colinoflynn/picoemp-tdc-paper/picoemp/hardware/gerbers/README.md

WARNING: Due to limtations in gerber editing these files are not fully anonymized.
