colinoflynn/picoemp-tdc-paper/paper-data-and-figures/caloutput.png

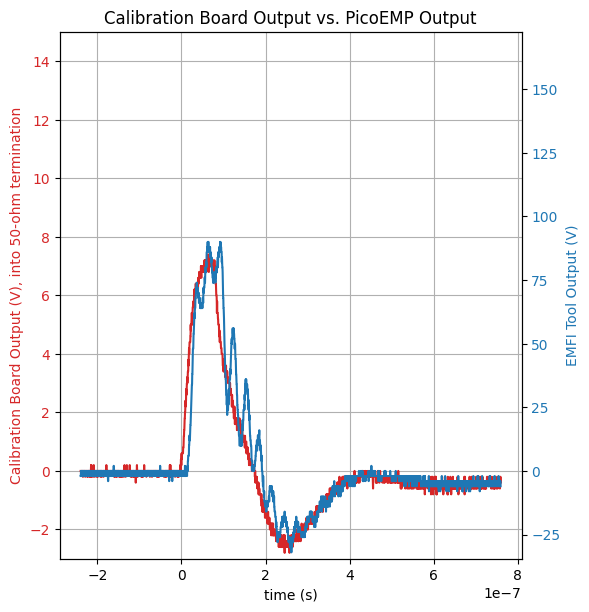
paper-data-and-figures/caloutput.png
