colinoflynn/picoemp-tdc-paper/paper-data-and-figures/caloutputcs.png

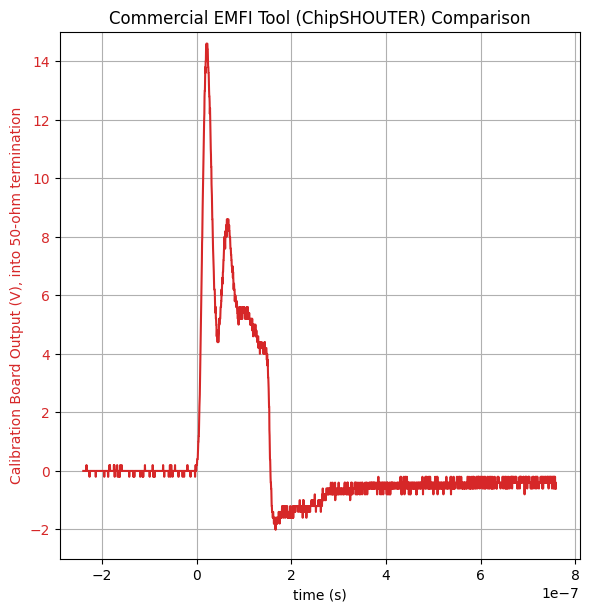
paper-data-and-figures/caloutputcs.png
