colinoflynn/picoemp-tdc-paper/paper-data-and-figures/FigureEMFIWidthEXT.png

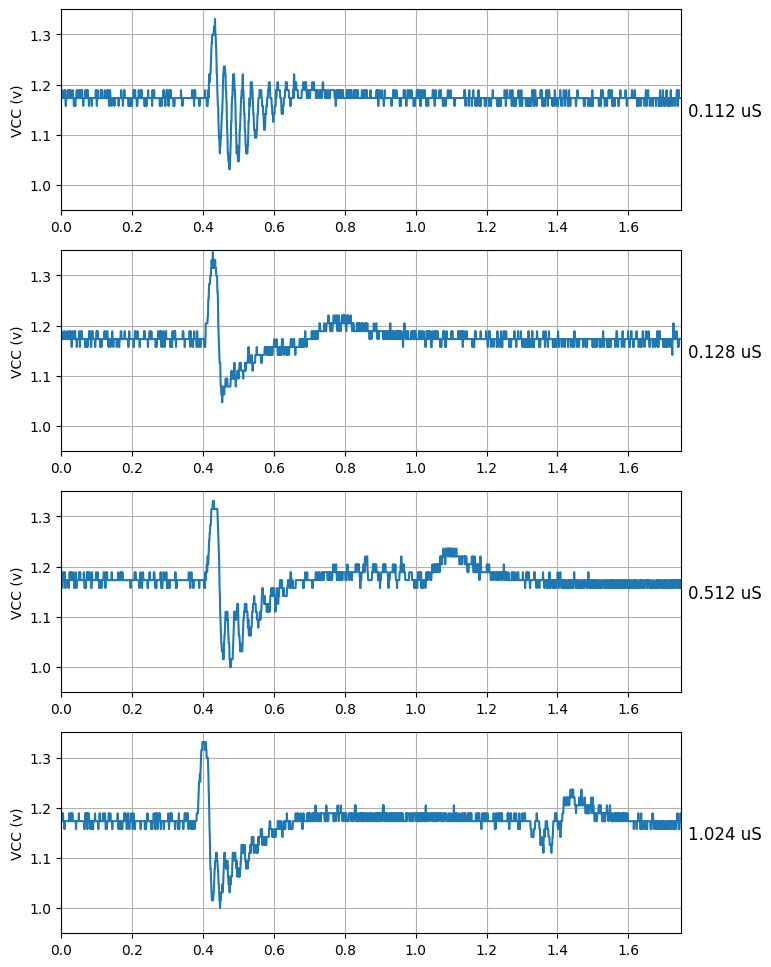
paper-data-and-figures/FigureEMFIWidthEXT.png
