colinoflynn/picoemp-tdc-paper/paper-data-and-figures/FigureEMFIWidthTDC.png

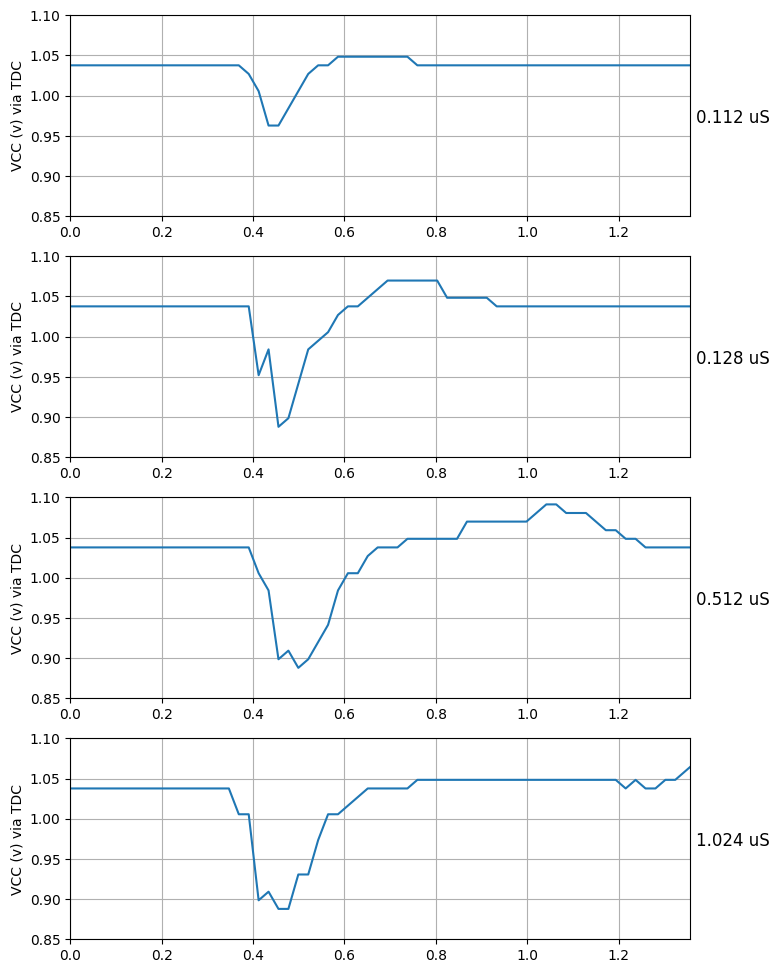
paper-data-and-figures/FigureEMFIWidthTDC.png
