colinoflynn/picoemp-tdc-paper/paper-data-and-figures/FigureHWAESVCCEXT.png

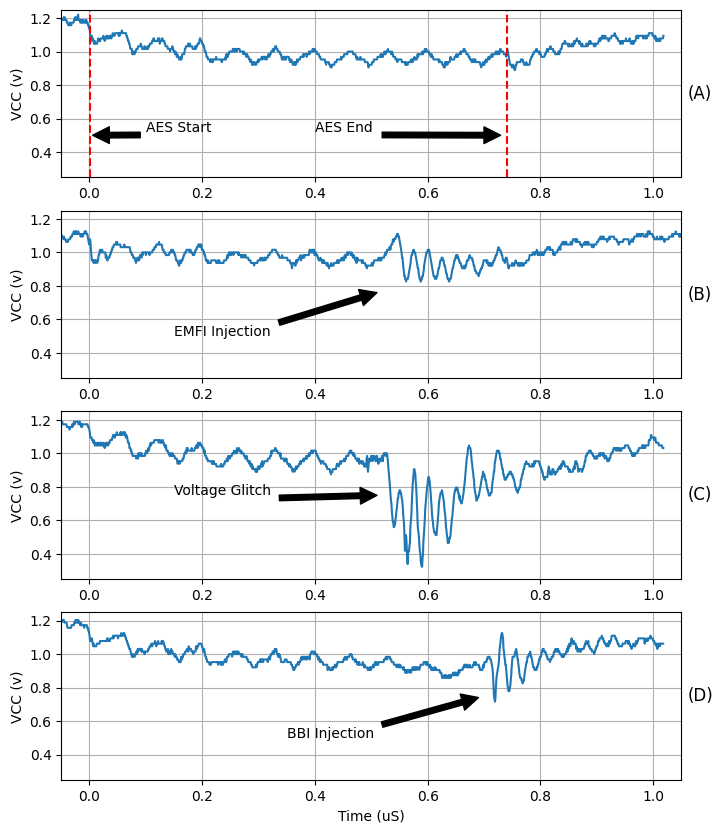
paper-data-and-figures/FigureHWAESVCCEXT.png
