colinoflynn/picoemp-tdc-paper/paper-data-and-figures/FigureHWAESVCCTDC.png

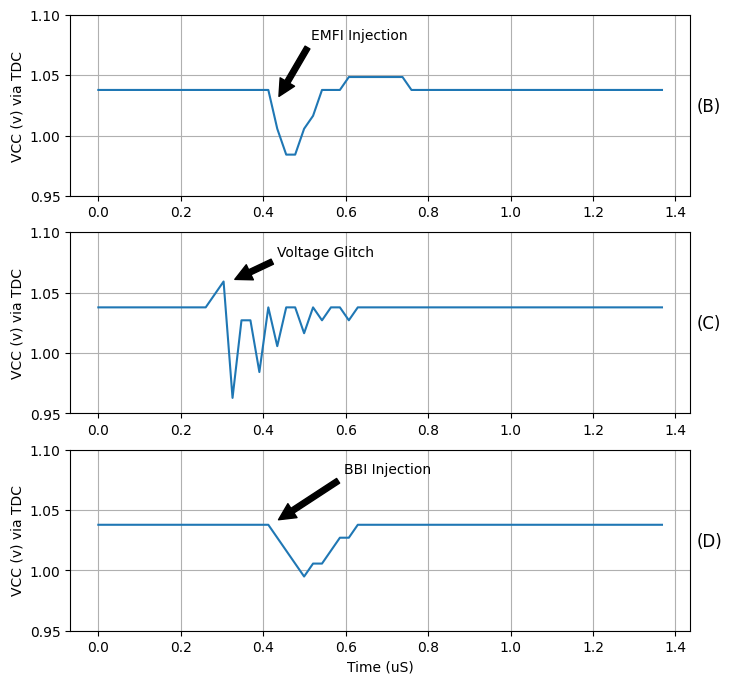
paper-data-and-figures/FigureHWAESVCCTDC.png
