colinoflynn/picoemp-tdc-paper/paper-data-and-figures/FigureSWVCCEXT.png

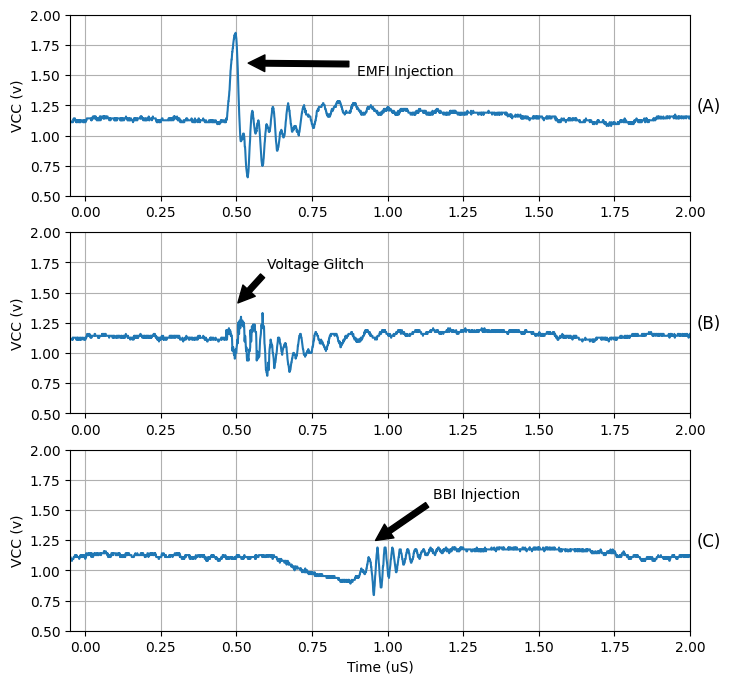
paper-data-and-figures/FigureSWVCCEXT.png
