colinoflynn/picoemp-tdc-paper/paper-data-and-figures/FigureSWVCCEXTEMFICompare.png

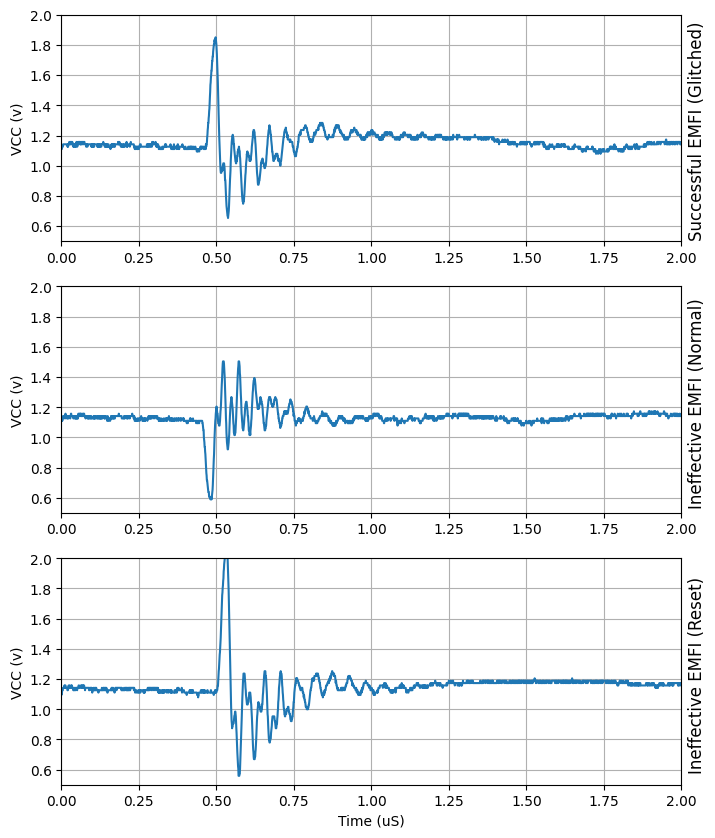
paper-data-and-figures/FigureSWVCCEXTEMFICompare.png
