colinoflynn/picoemp-tdc-paper/paper-data-and-figures/FigureSWVCCTDC.png

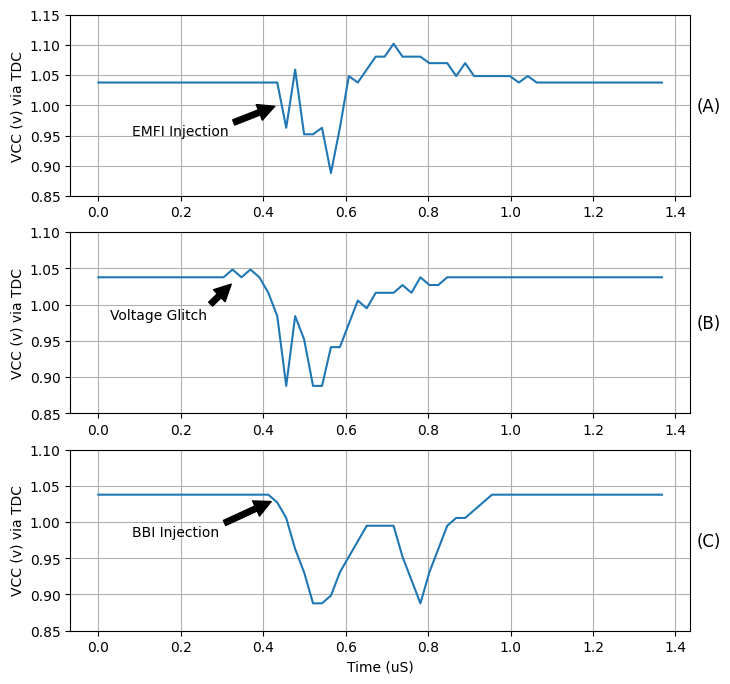
paper-data-and-figures/FigureSWVCCTDC.png
