colinoflynn/picoemp-tdc-paper/picoemp/hardware/demo.jpg

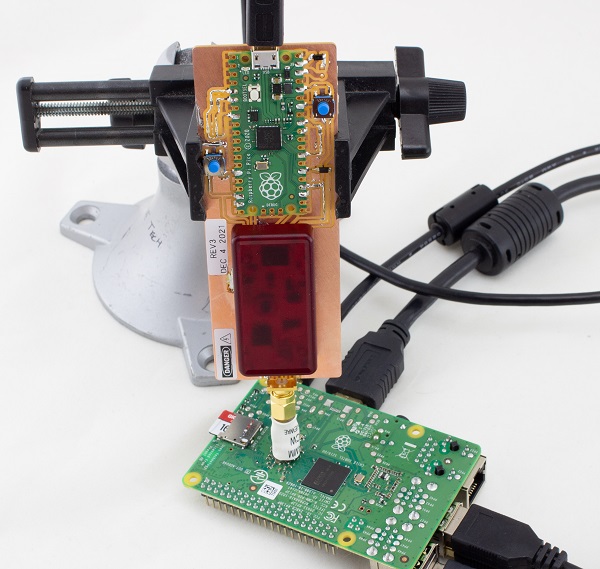
picoemp/hardware/demo.jpg
