colinoflynn/picoemp-tdc-paper/picoemp/hardware/design_notes/img/burninator.jpg

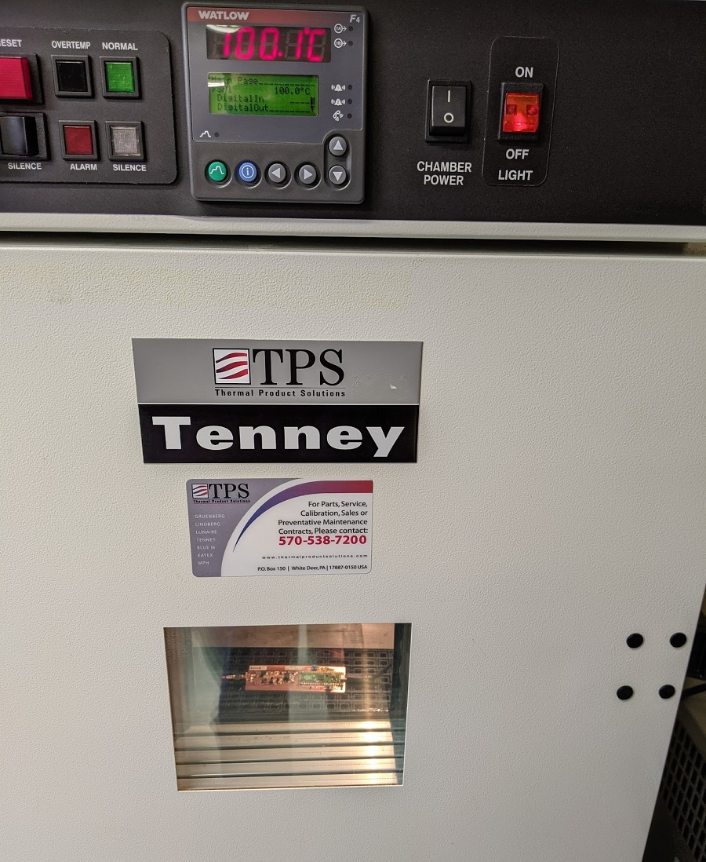
picoemp/hardware/design_notes/img/burninator.jpg
