colinoflynn/picoemp-tdc-paper/picoemp/hardware/design_notes/img/tek00000.png

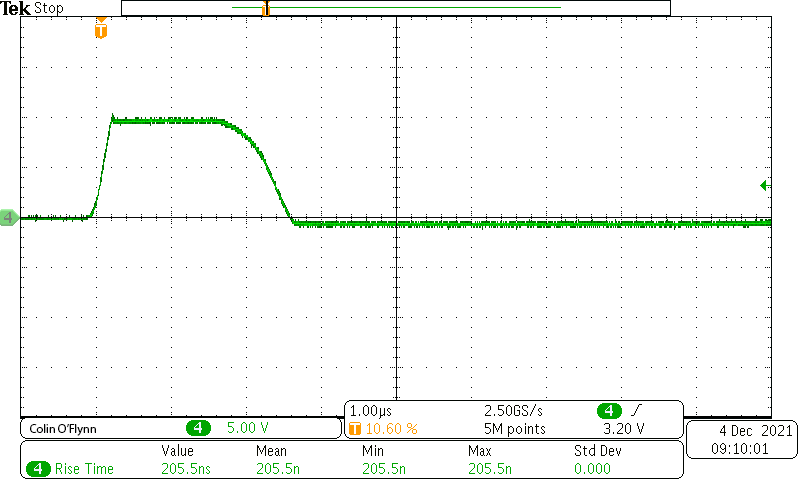
picoemp/hardware/design_notes/img/tek00000.png
