colinoflynn/picoemp-tdc-paper/picoemp/hardware/design_notes/img/tek00001.png

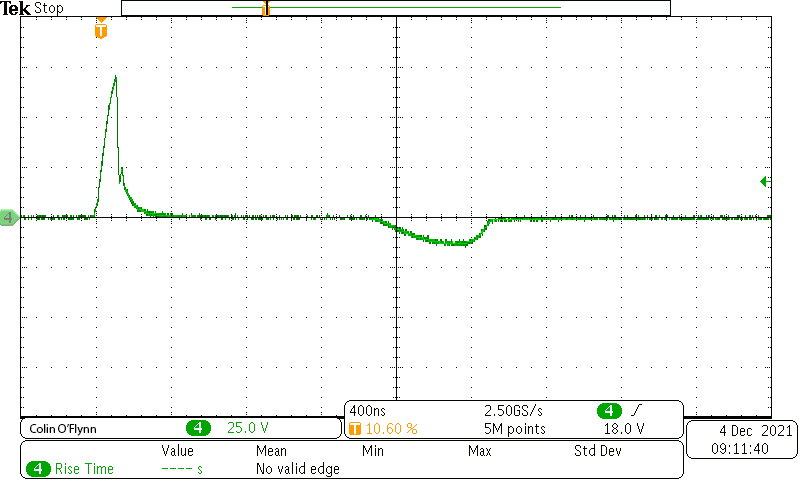
picoemp/hardware/design_notes/img/tek00001.png
