colinoflynn/picoemp-tdc-paper/picoemp/hardware/design_notes/img/tek00003.png

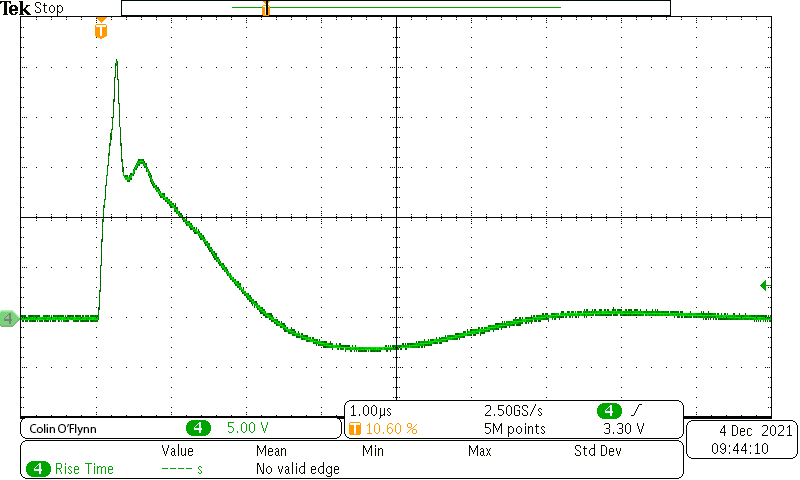
picoemp/hardware/design_notes/img/tek00003.png
