colinoflynn/picoemp-tdc-paper/picoemp/hardware/design_notes/img/tek00004.png

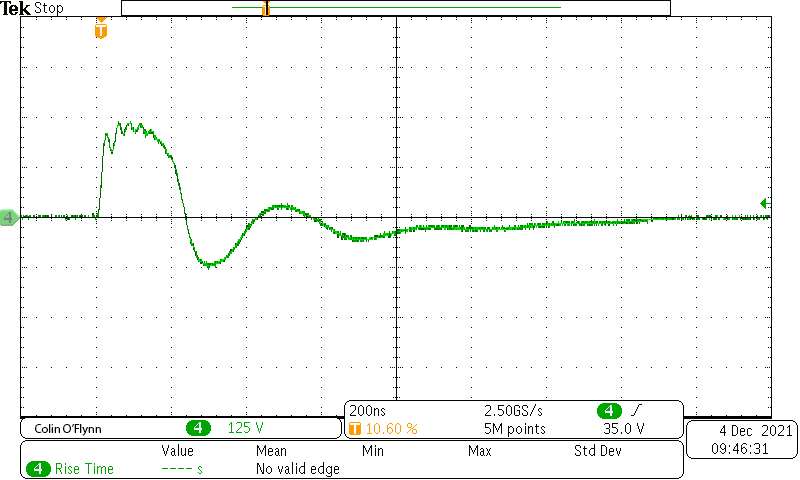
picoemp/hardware/design_notes/img/tek00004.png
