colinoflynn/picoemp-tdc-paper/picoemp/hardware/design_notes/img/tek00007.png

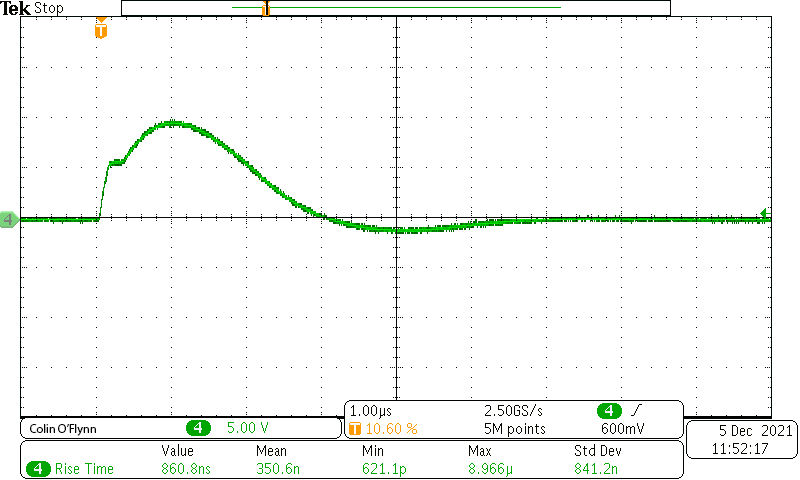
picoemp/hardware/design_notes/img/tek00007.png
