colinoflynn/picoemp-tdc-paper/picoemp/hardware/design_notes/img/tek00009.png

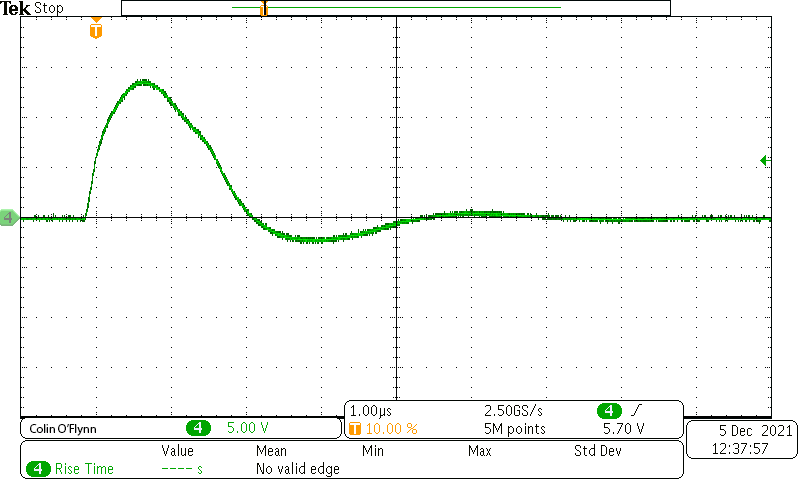
picoemp/hardware/design_notes/img/tek00009.png
