colinoflynn/picoemp-tdc-paper/picoemp/hardware/design_notes/img/tek00011.png

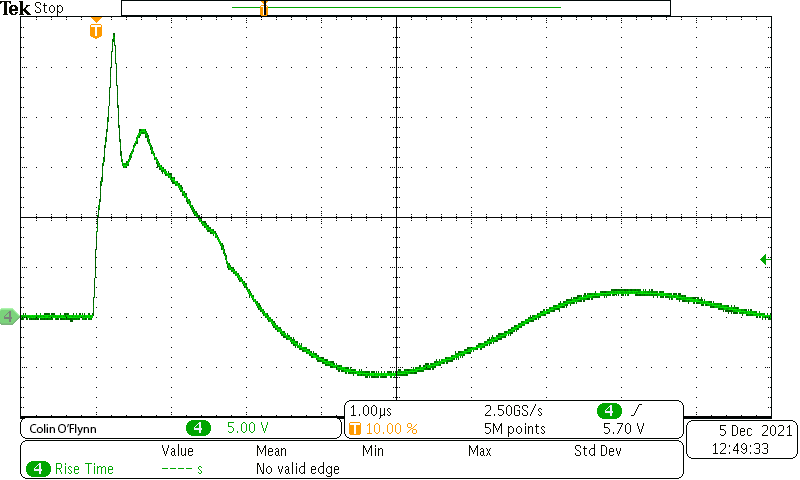
picoemp/hardware/design_notes/img/tek00011.png
