colinoflynn/picoemp-tdc-paper/picoemp/hardware/design_notes/img/tek00012.png

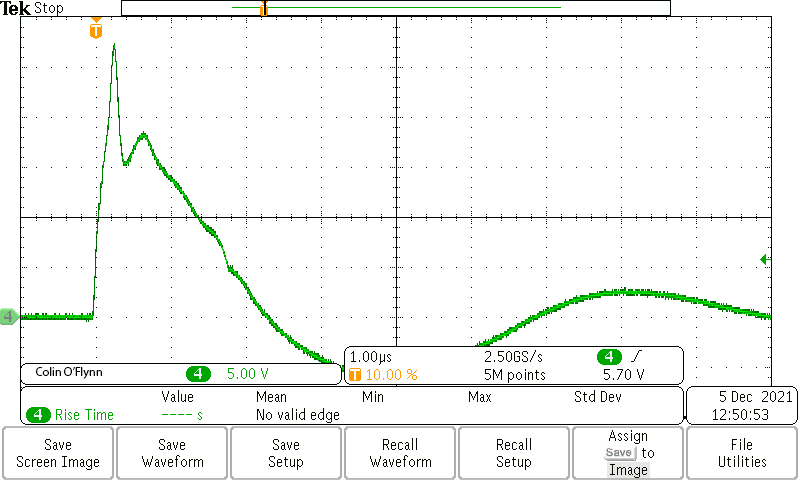
picoemp/hardware/design_notes/img/tek00012.png
