colinoflynn/picoemp-tdc-paper/picoemp/hardware/design_notes/img/tek00017.png

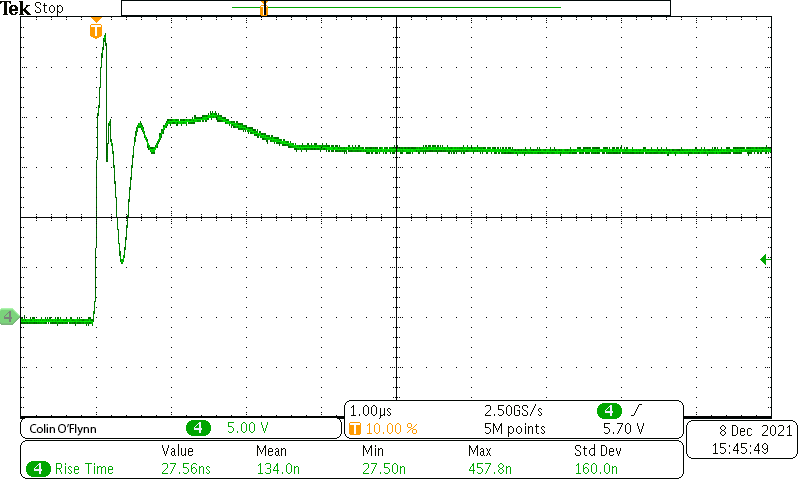
picoemp/hardware/design_notes/img/tek00017.png
