colinoflynn/picoemp-tdc-paper/picoemp/hardware/design_notes/img/tek00018.png

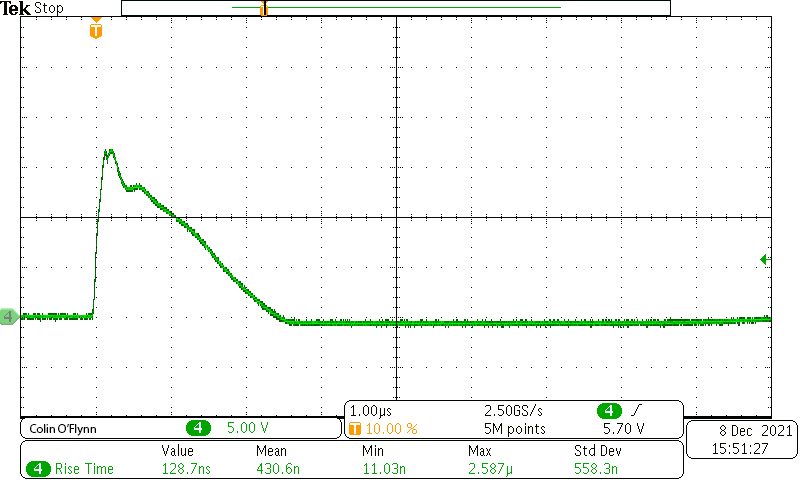
picoemp/hardware/design_notes/img/tek00018.png
