colinoflynn/picoemp-tdc-paper/picoemp/hardware/gerbers/rev04_img/bantam_copperpour.jpg

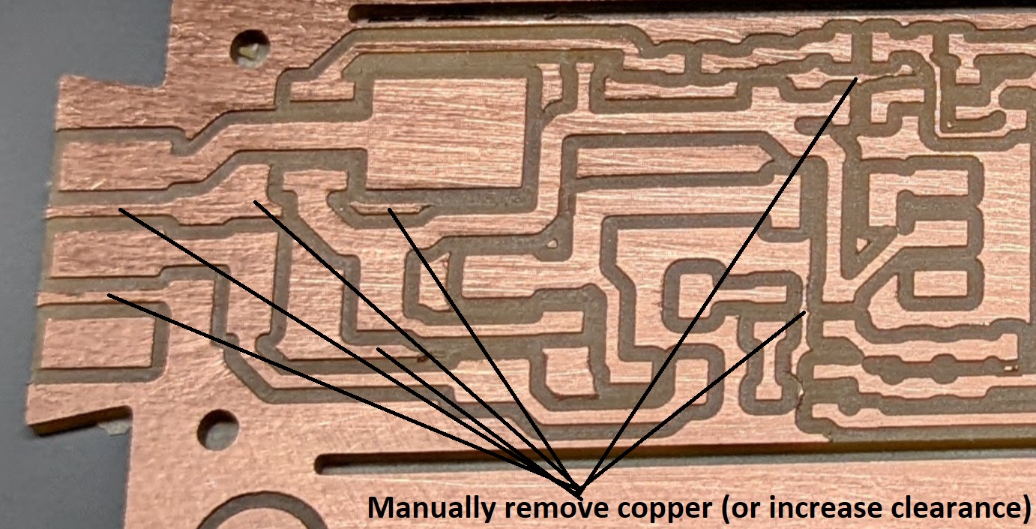
picoemp/hardware/gerbers/rev04_img/bantam_copperpour.jpg
