colinoflynn/picoemp-tdc-paper/picoemp/hardware/gerbers/rev04_img/bantam_example.jpg

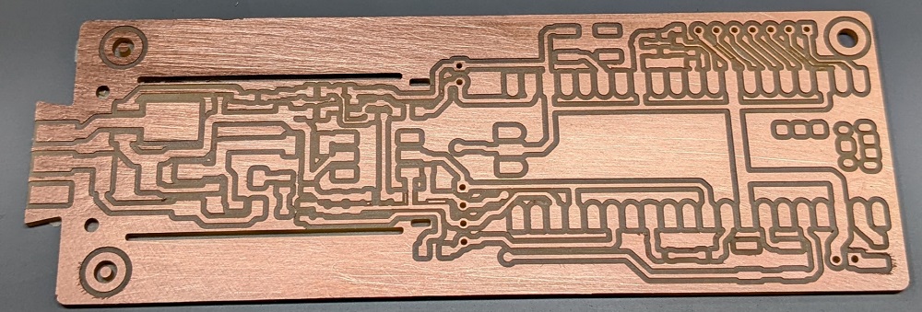
picoemp/hardware/gerbers/rev04_img/bantam_example.jpg
