colinoflynn/picoemp-tdc-paper/picoemp/hardware/gerbers/rev04_img/bantam_jumpers.png

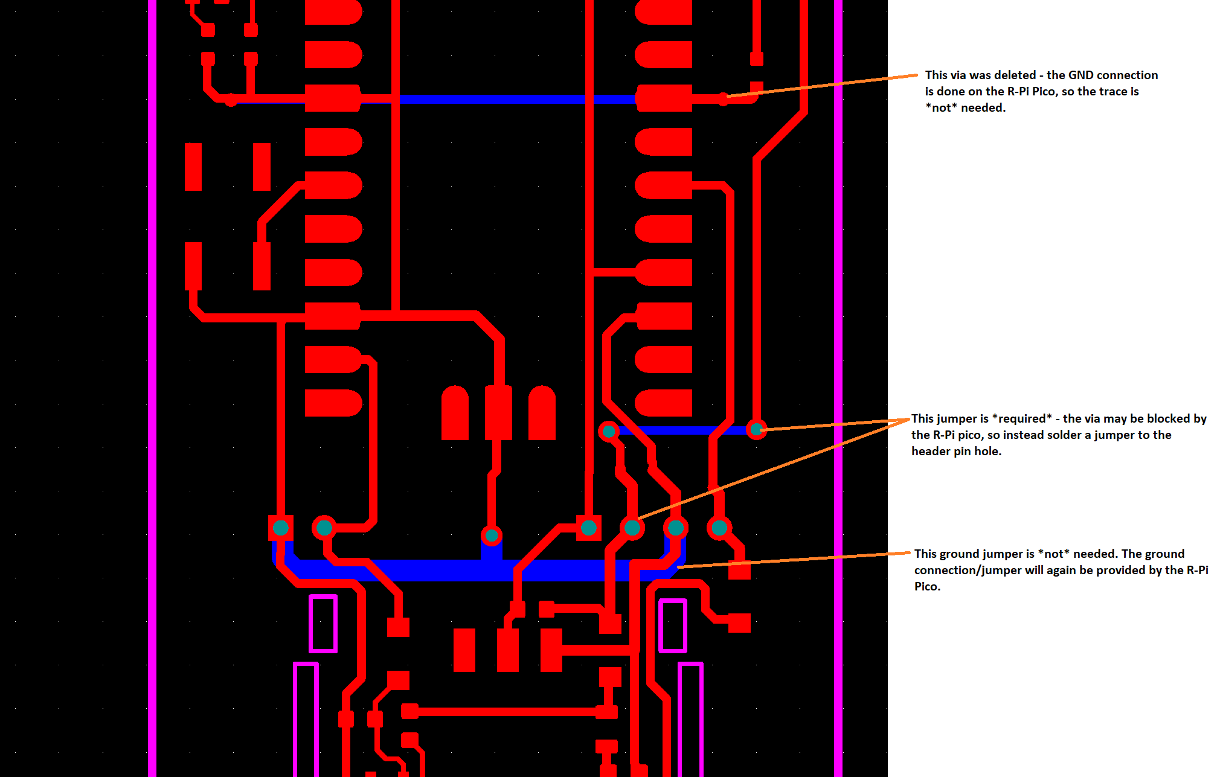
picoemp/hardware/gerbers/rev04_img/bantam_jumpers.png
