colinoflynn/picoemp-tdc-paper/picoemp/hardware/gerbers/rev04_img/bantam_shorts.jpg

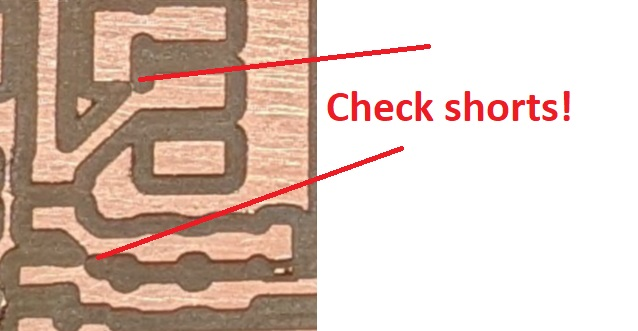
picoemp/hardware/gerbers/rev04_img/bantam_shorts.jpg
