colinoflynn/picoemp-tdc-paper/picoemp/hardware/injection_tips/examples/tip-coilcraft-inductor.jpg

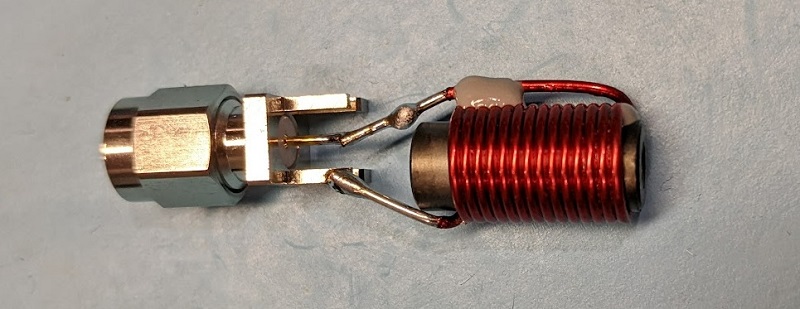
picoemp/hardware/injection_tips/examples/tip-coilcraft-inductor.jpg
