colinoflynn/picoemp-tdc-paper/picoemp/hardware/injection_tips/examples/tip-largertorrid-broken.jpeg

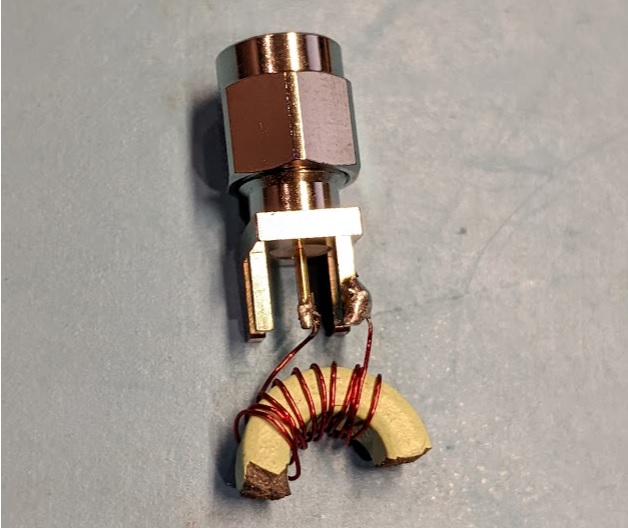
picoemp/hardware/injection_tips/examples/tip-largertorrid-broken.jpeg
