colinoflynn/picoemp-tdc-paper/picoemp/hardware/injection_tips/examples/tip-shaped-wurthcompare.jpg

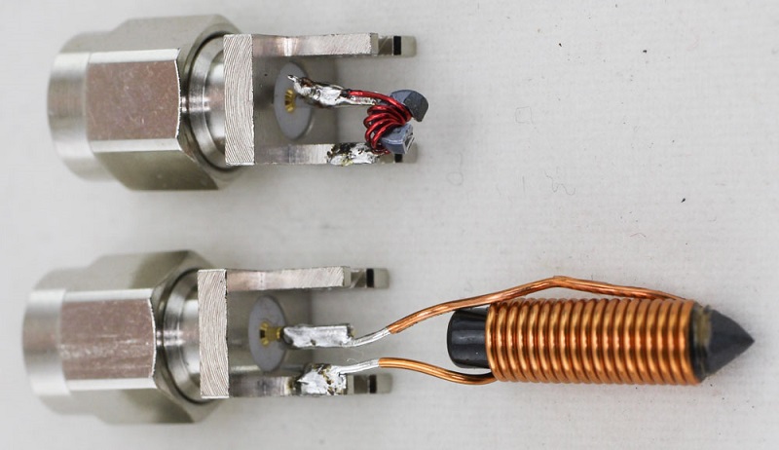
picoemp/hardware/injection_tips/examples/tip-shaped-wurthcompare.jpg
