colinoflynn/picoemp-tdc-paper/picoemp/hardware/injection_tips/examples/tip-slant.jpg

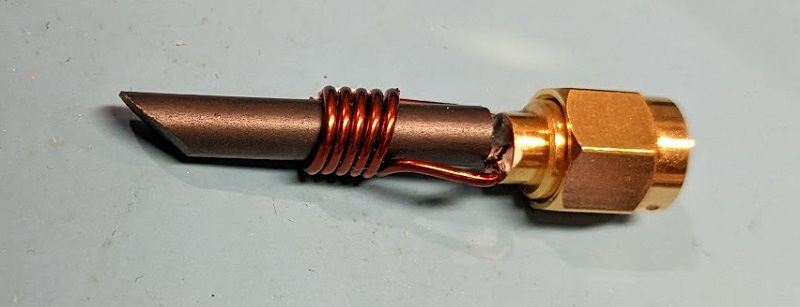
picoemp/hardware/injection_tips/examples/tip-slant.jpg
