colinoflynn/picoemp-tdc-paper/picoemp/hardware/injection_tips/examples/tip-wurth-th.jpg

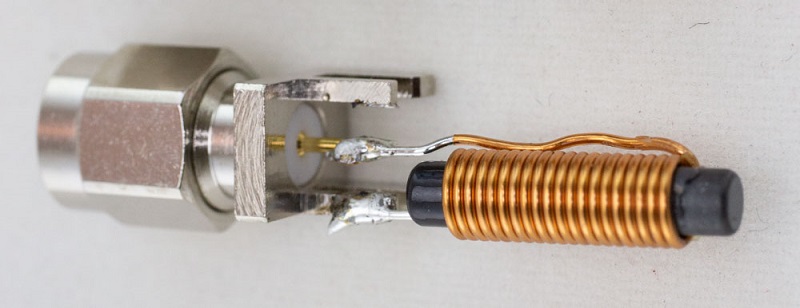
picoemp/hardware/injection_tips/examples/tip-wurth-th.jpg
