colinoflynn/picoemp-tdc-paper/picoemp/hardware/injection_tips/examples/tip_WE_744779068.jpg

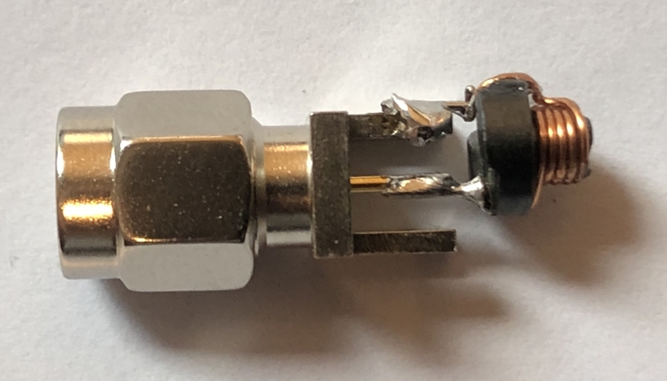
picoemp/hardware/injection_tips/examples/tip_WE_744779068.jpg
