colinoflynn/picoemp-tdc-paper/picoemp/hardware/injection_tips/examples/wetwheel.jpg

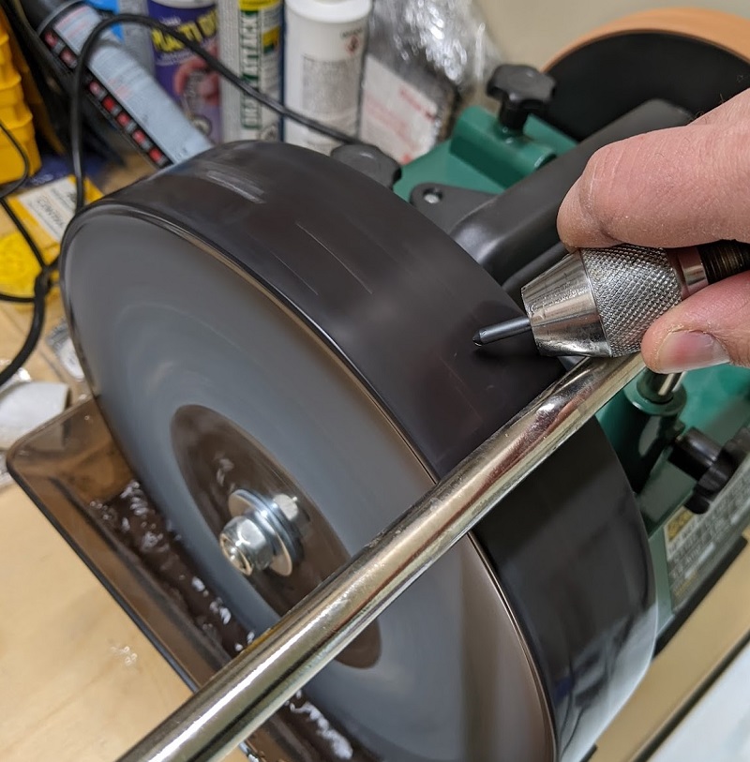
picoemp/hardware/injection_tips/examples/wetwheel.jpg
