colinoflynn/picoemp-tdc-paper/picoemp/hardware/shield/3dprint_example.jpg

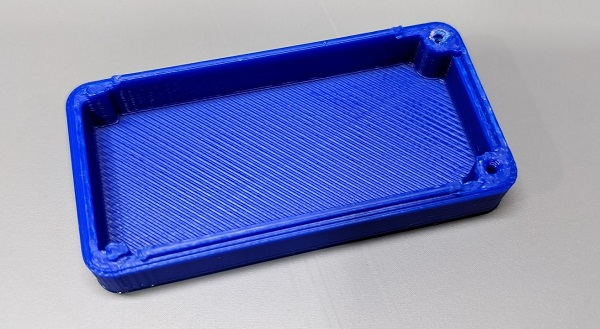
picoemp/hardware/shield/3dprint_example.jpg
