colinoflynn/picoemp-tdc-paper/picoemp/hardware/BOM for PicoEMP - Production Costs.xls

Line # | Name | Description | Designator | Quantity | Manufacturer 1 | Manufacturer Part Number 1 | Supplier 1 | Supplier Part Number 1 | Alternate 2 | Cost
 | Plastic Shield | Plastic Shield |  | 1 | Hammond Manufacturing | 1551BTRD | Digi-Key | HM1624-ND |  | 2.88
 | 4.7uF/50V | 4u7, 50V, 0805, Ceramic | C1, C2 | 2 | TDK | C2012X5R1H475K125AB | Digi-Key | 445-5980-1-ND |  | 0.3
 | 0.47uF,630V,X7T | 0.47uF, 630V, X7T, Stacked | C3 | 1 | Murata | KRM55TR72J474MH01K | Digi-Key | 490-16845-1-ND | CGA9P1X7T2J474K250KE | 1.2
 | 100n | 100n, 0603 | C5 | 1 | KEMET | C0603C104K5RACTU | Digi-Key | 399-5089-2-ND
 | SM4005PL-TP |  | D1, D3, D4, D5 | 4 | MCC | SM4005PL-TP | Digi-Key | SM4005PL-TPMSCT-ND |  | 0.0881
 | MURA160T3G | 600V, 1A, Fast Recovery Diode | D2 | 1 | ON Semiconductor | MURA160T3G |  |  | US1J-13-F | 0.17778
 | LED, 0603, Red | Chip LED, Red | D6, D9 | 2 | Kingbright | APT1608SRCPRV | Digi-Key | 754-1122-1-ND |  | 0.06896
 | MM3Z18VB |  | D7 | 1 | ON Semiconductor / Fairchild | MM3Z18VB | Digi-Key | MM3Z18VBCT-ND |  | 0.05764
 | LED, 0603, Green | Chip LED, Green | D8 | 1 | Kingbright | APT1608CGCK | Digi-Key | 754-1116-1-ND |  | 0.06057
 | EDGE-SMA | Edge-Mount SMA, 0.062" PCB | J1 | 1 | Molex | 732511150 | Digi-Key |  | 142-0701-801 | 1.81
 | 1x2_Pin_Header | JST XH 0.1" HEADER | J2 | 1 | JST | S2B-XH-A(LF)(SN) | Digi-Key | 455-2257-ND |  | 0.1596
 | BG306-02-A-2-0400-L-G | 2-Pin SMD, Female Header, 0.1" spacing | J3 | 1 | Global Connector Technology | BG306-02-A-2-0400-L-G | Newark | 07W6674 |  | 0.5714
 | LDA111STR | Phototransistor | Q1 | 1 | Ixys Clare | LDA111STR | Digi-Key | 212-LDA111SCT-ND |  | 0.65604
 | RGT16BM65DTL | IGBT 650V | Q2 | 1 | Rohm | RGT16BM65DTL | Mouser | 755-RGT16BM65DTL |  | 1.45
 | AO3422 | MOSFET N-CH 30V 2.2A SOT23-3 | Q3, Q4 | 2 |  | AO3422 |  |  | PMV37ENEAR | 0.19036
 | 20M | 20M, 2010, 1% | R1 | 1 |  | CRMA2010AF20M0FKEF | Digi-Key
 | 300K | 300K res, 2512, 1%, 3W | R2 | 1 | TE Connectivity CGS | 3522300KFT | Digi-Key | A121215CT-ND |  | 0.476
 | 10R | 10R res, 0603, 1%, 1/10W | R3, R7 | 2 | Yageo | RC0603FR-0710RL | Digi-Key | 311-10.0HRCT-ND
 | 75R | 75R res, 0805, 1%, 1/8W | R4 | 1 | Yageo | RC0805FR-0775RL | Digi-Key | 311-75.0CRCT-ND
 | 1k | 1k res, 0603, 1%, 1/10W | R5, R10, R11, R12, R13 | 5 | Yageo | RC0603FR-071KL | Digi-Key | 311-1.00KHRCT-ND
 | 22k | 22k res, 0603, 1%, 1/10W | R6 | 1 | Yageo | RC0603FR-0722KL | Digi-Key | 311-22.0KHRCT-ND
 | 2k | 2k, 0805, 1%, 1/8W | R9 | 1 | Yageo | RC0805FR-072KL | Digi-Key | 311-2.00KCRCT-ND
 | KSC741J LFS | SWITCH TACTILE SPST-NO 0.01A 32V | SW1, SW2 | 2 | ITT C&K | KSC741JLFS | Digi-Key | CKN10309CT-ND |  | 0.42842
 | TL3301AF160QJ | SWITCH TACTILE SPST-NO 0.01A 32V | SW3 | 1 | E-Switch | TL3301AF160QJ |  |  |  | 0.36342
 | ATB322524 | HV Transformer 1:10, Small | T1, T2 | 2 | TDK | ATB322524-0110-T000 | Digi-Key | 445-8636-1-ND |  | 1.03 | 15.96829
 | SC0915 | Raspberry Pi Pico | U1 | 1 | Raspberry Pi | SC0915 |  |  |  | 4
 | PRT-09925 | Battery Holder, 2xAA, with Switch | BH1 | 1 | Sparkfun Electronics | PRT-09925 |  |  |  | 2.07
 | Probe: SMA | For Example Probe |  | 1 |  | CONSMA013.062
 | Probe: Inductor | For Example Probe |  | 1 |  | PCV-0-472-03L
 | Package: Protective Pak |  |  |  |  |  |  |  |  | 4.01
 | USB Isolator
 | Micro-USB Cable |  |  |  |  |  |  |  |  | 2
 |  |  |  |  |  |  |  |  |  | 24.04829
