colinoflynn/picoemp-tdc-paper/picoemp/hardware/jlcpcb.xls

Line # | Name | Description | Designator | Quantity | Manufacturer 1 | Manufacturer Part Number 1
 | Plastic Shield
 | 4.7uF/50V | 4u7, 50V, 0805, Ceramic | C1, C2 | 2 | TDK | C2012X5R1H475K125AB
 | 0.47uF,630V,X7T | 0.47uF, 630V, X7T, Stacked | C3 | 1 | Murata | KRM55TR72J474MH01K
 | 100n | 100n, 0603 | C5 | 1 | KEMET | C0603C104K5RACTU
 | SM4005PL-TP |  | D1, D3, D4, D5 | 4 | MCC | SM4005PL-TP
 | MURA160T3G | 600V, 1A, Fast Recovery Diode | D2 | 1 | ON Semiconductor | MURA160T3G
 | LED, 0603, Red | Chip LED, Red | D6, D9 | 2 | Kingbright | APT1608SRCPRV
 | MM3Z18VB |  | D7 | 1 | ON Semiconductor / Fairchild | MM3Z18VB
 | LED, 0603, Green | Chip LED, Green | D8 | 1 | Kingbright | APT1608CGCK
 | EDGE-SMA
 | 1x2_Pin_Header
 | BG306-02-A-2-0400-L-G | 2-Pin SMD, Female Header, 0.1" spacing | J3 | 1 | Global Connector Technology | BG306-02-A-2-0400-L-G
 | LDA111STR | Phototransistor | Q1 | 1 | Ixys Clare | LDA111STR
 | RGT16BM65DTL | IGBT 650V | Q2 | 1 | Rohm | RGT16BM65DTL
 | AO3422 | MOSFET N-CH 30V 2.2A SOT23-3 | Q3, Q4 | 2 |  | AO3422
 | 20M | 20M, 2010, 1% | R1 | 1 |  | CRMA2010AF20M0FKEF
 | 300K | 300K res, 2512, 1%, 3W | R2 | 1 | TE Connectivity CGS | 3522300KFT
 | 10R | 10R res, 0603, 1%, 1/10W | R3, R7 | 2 | Yageo | RC0603FR-0710RL
 | 75R | 75R res, 0805, 1%, 1/8W | R4 | 1 | Yageo | RC0805FR-0775RL
 | 1k | 1k res, 0603, 1%, 1/10W | R5, R10, R11, R12, R13 | 5 | Yageo | RC0603FR-071KL
 | 22k | 22k res, 0603, 1%, 1/10W | R6 | 1 | Yageo | RC0603FR-0722KL
 | 2k | 2k, 0805, 1%, 1/8W | R9 | 1 | Yageo | RC0805FR-072KL
 | KSC741J LFS
 | TL3301AF160QJ | SWITCH TACTILE SPST-NO 0.01A 32V | SW3 | 1 | E-Switch | TL3301AF160QJ
 | ATB322524 | HV Transformer 1:10, Small | T1, T2 | 2 | TDK | ATB322524-0110-T000
 | SC0915
 | PRT-09925
 | Probe: SMA
 | Probe: Inductor
