colinoflynn/picoemp-tdc-paper/picoemp/hardware/shield/picoempshield-1551BTRD-top.stl

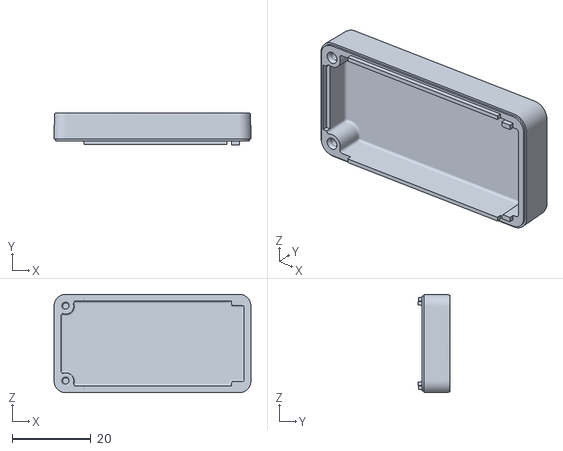
[picture p38: CAD file, 2023-06-04]
picoemp/hardware/shield/picoempshield-1551BTRD-top.stl
50.0 x 8.00 x 25.0
