colinoflynn/picoemp-tdc-paper/(list of files, cad)

Other CAD files:
picoemp/hardware/shield/picoempshield-1551BTRD-top.f3d
