colinoflynn/picoemp-tdc-paper/paper-data-and-figures/TDCCalibration.png

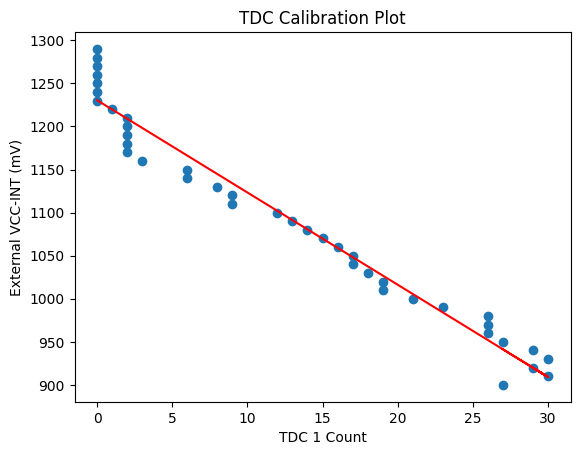
paper-data-and-figures/TDCCalibration.png
