colinoflynn/picoemp-tdc-paper/picoemp/hardware/SCH-PICOEMP-REV04.PDF

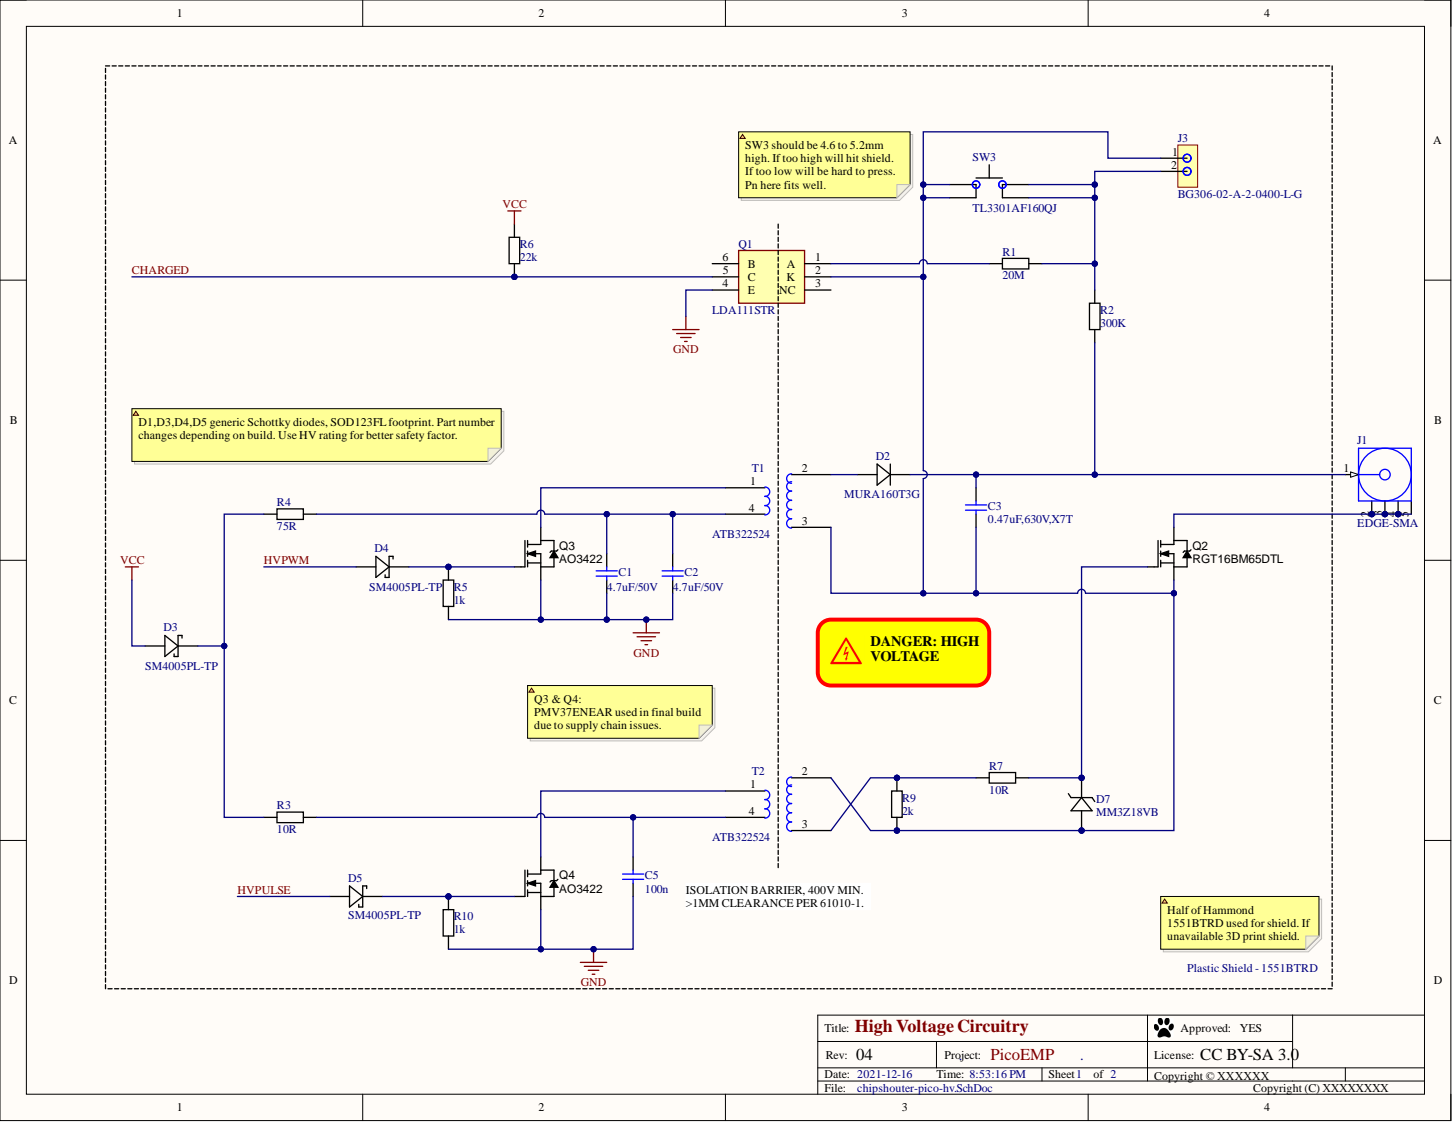
[picture p40: page 1]

SW3 should be 4.6 to 5.2mm
high. If too high will hit shield.
If too low will be hard to press.
Pn here fits well.

D1,D3,D4,D5 generic Schottky diodes, SOD123FL footprint. Part number
changes depending on build. Use HV rating for better safety factor.

PMV37ENEAR used in final build
due to supply chain issues.

Half of Hammond
1551BTRD used for shield. If
unavailable 3D print shield.

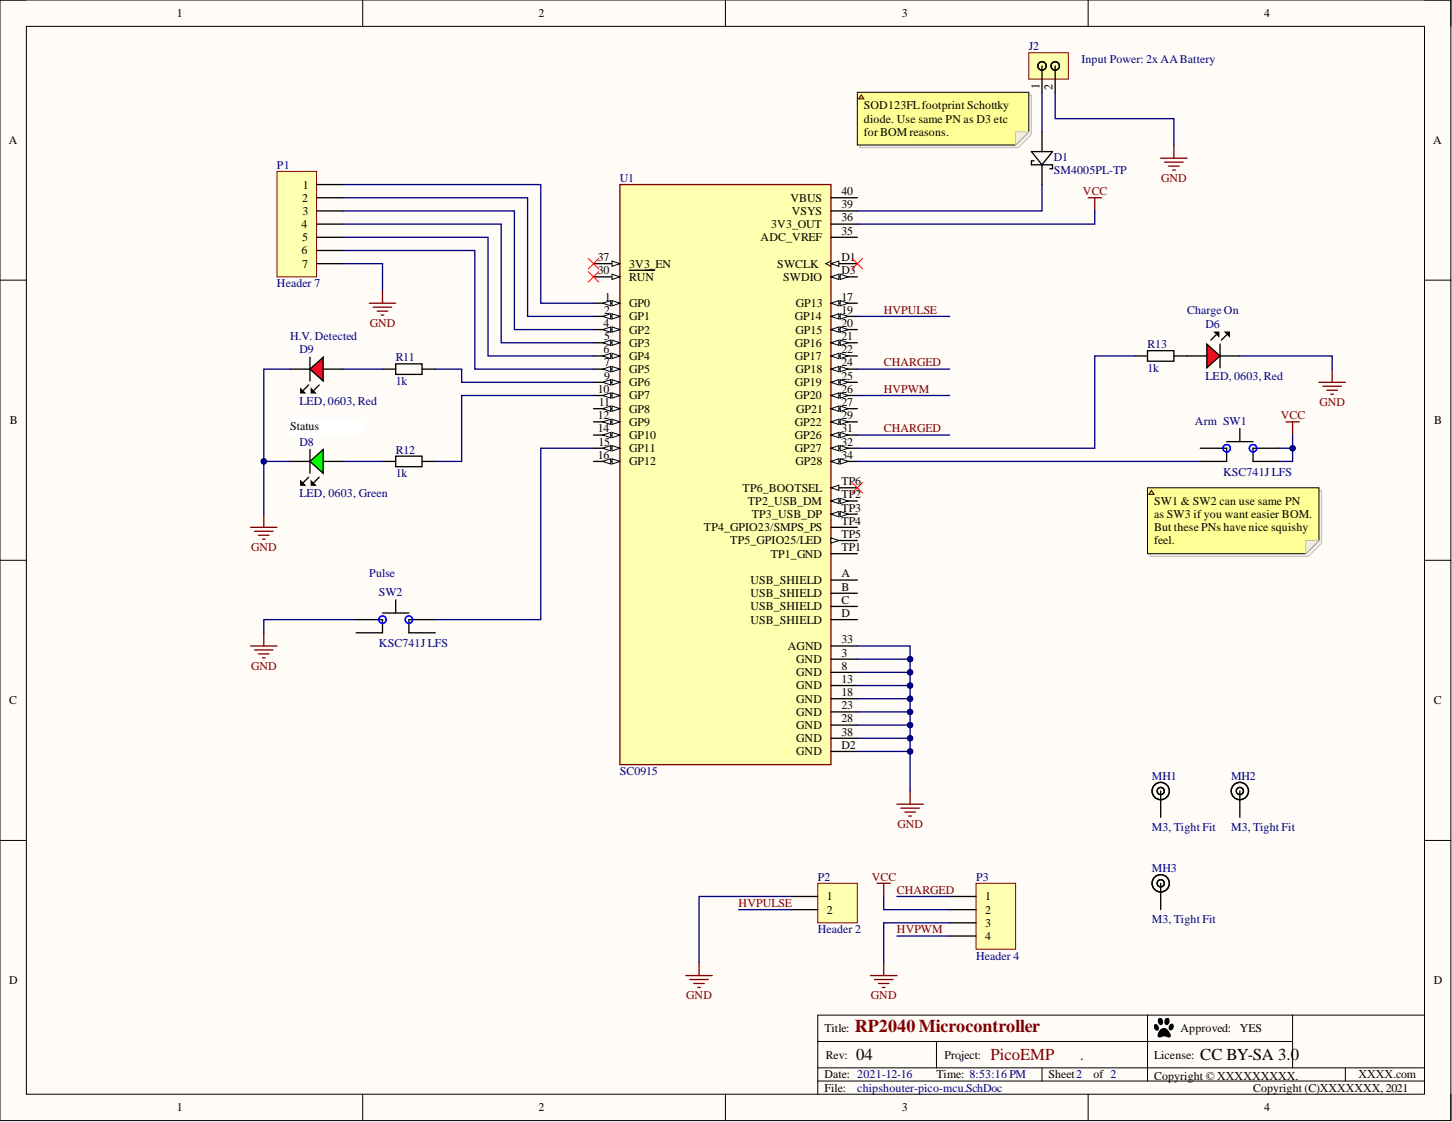
[picture p41: page 2]

Input Power: 2x AA Battery

SOD123FL footprint Schottky
diode. Use same PN as D3 etc
for BOM reasons.

GND | GP2 4

GP3 5
GP4 6

R11 | GP5 7 GP6 9 | CHARGED

SW1 & SW2 can use same PN
as SW3 if you want easier BOM.
But these PNs have nice squishy
feel.
