colinoflynn/picoemp-tdc-paper/(list of files, drawings)

Other design files:
picoemp/hardware/altium_src/chipshouter-pico-hv.SchDoc
picoemp/hardware/altium_src/chipshouter-pico-mcu.SchDoc
picoemp/hardware/altium_src/chipshouter-pico-panel.PcbDoc
picoemp/hardware/altium_src/chipshouter-pico.PcbDoc
picoemp/hardware/altium_src/ChipShouter-Pico.PrjPcb
picoemp/hardware/hcal_board/EMFI_HCAL.PcbDoc
picoemp/hardware/hcal_board/EMFI_HCAL.SchDoc
picoemp/hardware/hcal_board/Hcal_Board.PrjPcb
