colinoflynn/picoemp-tdc-paper/(commit log)

2023-06-04 Add repo data
    [BOM for PicoEMP - Production Costs.xls, BOM for PicoEMP.xls, ChipShouter-Pico.PrjPcb, chipshouter-pico-hv.SchDoc, chipshouter-pico-mcu.SchDoc, chipshouter-pico-panel.PcbDoc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]
2023-06-04 Add calibration PCB design
    [EMFI_HCAL.PcbDoc, EMFI_HCAL.SchDoc, Hcal_Board.PrjPcb]
