colinoflynn/picoemp-tdc-paper/(notices)

Notices in the files:
picoemp/README.md:
CC BY-SA 3.0
